magicsmoke/OCDH/README.md

View this project on [CADLAB.io](https://cadlab.io/project/25315). 

# OCDH
Open Source Diesel Heater
