magicsmoke/OCDH/ECU/pcb/ocdh_ecu.kicad_pcb

## KiCad design ECU/pcb/ocdh_ecu.kicad_pcb (2022-03-17)

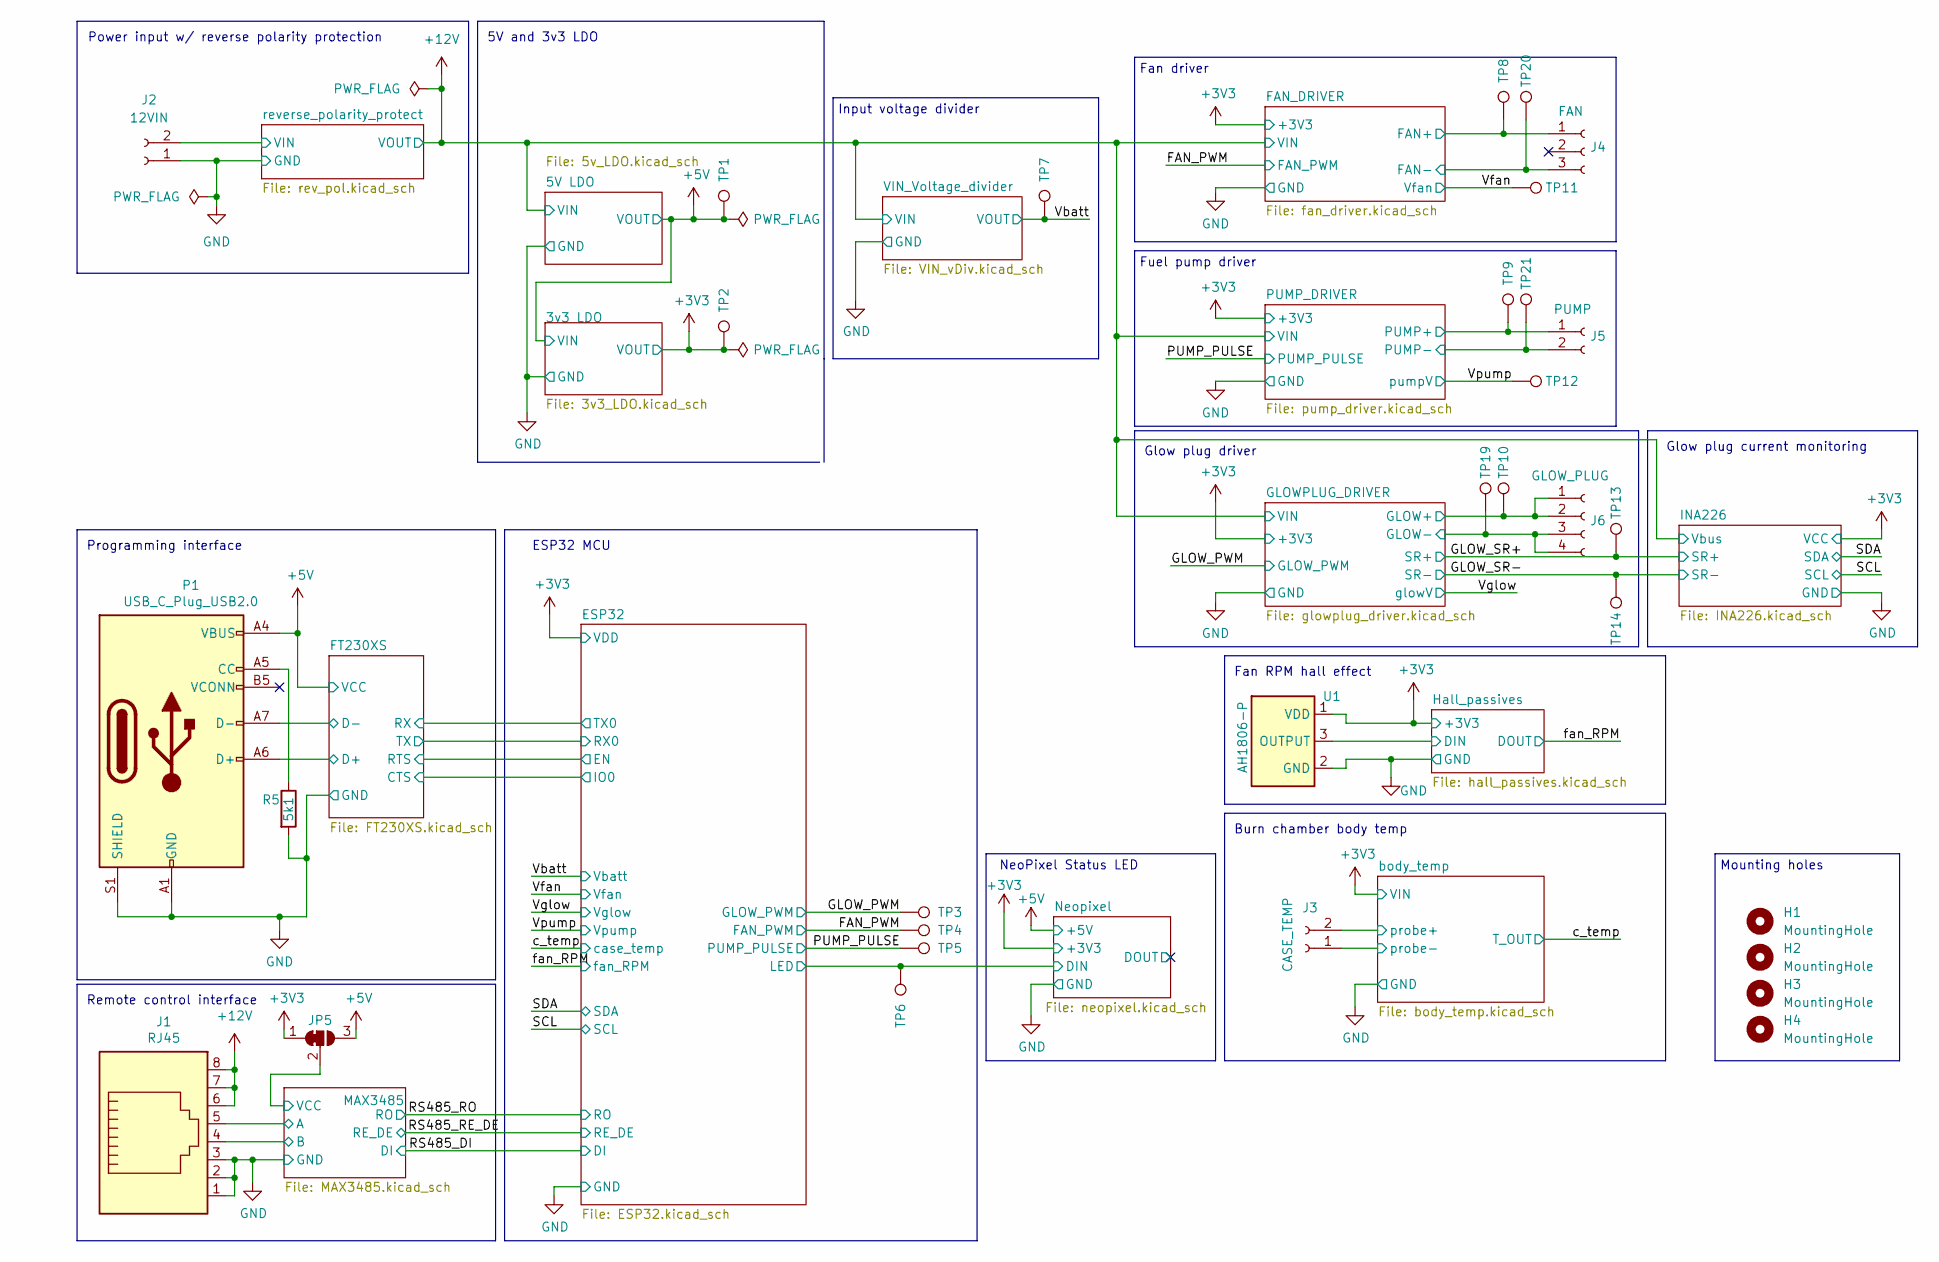
[picture p16: schematic ocdh_ecu.kicad_sch, CDH_ECU]

Parts:
H1, H2, H3, H4: MountingHole; MountingHole_3mm
J1: RJ45; RJ45_Amphenol_54602-x08_Horizontal
J2: 12VIN; SolderWire-1.5sqmm_1x02_P6mm_D1.7mm_OD3mm
J3: CASE_TEMP; SolderWire-1sqmm_1x02_P5.4mm_D1.4mm_OD2.7mm
J4: FAN; SolderWire-1sqmm_1x02_P5.4mm_D1.4mm_OD2.7mm
J5: PUMP; SolderWire-1sqmm_1x02_P5.4mm_D1.4mm_OD2.7mm
J6: GLOW_PLUG; SolderWire-1sqmm_1x02_P5.4mm_D1.4mm_OD2.7mm
JP5: RS485 PWR; SolderJumper-3_P1.3mm_Bridged12_RoundedPad1.0x1.5mm
P1: USB_C_Plug_USB2.0; GCT_USB4105-GF-A
R5: 5k1; R_0805_2012Metric
TP1, TP2, TP3, TP4, TP5, TP6, TP7, TP8, TP9, TP10, TP11, TP12, TP13, TP14, TP19, TP20, TP21: TestPoint; TestPoint_Pad_D1.5mm
U1: AH1806-P; TO265P160X410X495-3P

Connections:
+3V3: JP5.1 (A), TP2.1, U1.1 (VDD); also elsewhere on the board
+5V: JP5.3 (B), P1.A4 (VBUS), P1.A9 (VBUS), P1.B4 (VBUS), P1.B9 (VBUS), TP1.1; also elsewhere on the board
+12V: J1.6, J1.7, J1.8, J6.1, J6.2, TP10.1; also elsewhere on the board
/FAN_DRIVER/FAN+: J4.1, TP8.1; also elsewhere on the board
/FAN_DRIVER/FAN-: J4.3, TP20.1; also elsewhere on the board
/FAN_PWM: TP4.1; also elsewhere on the board
/FT230XS/D+: P1.A6 (D+), P1.B6 (D+); also elsewhere on the board
/FT230XS/D-: P1.A7 (D-), P1.B7 (D-); also elsewhere on the board
/GLOWPLUG_DRIVER/GLOW-: J6.3, J6.4, TP19.1; also elsewhere on the board
/GLOW_PWM: TP3.1; also elsewhere on the board
/GLOW_SR+: TP13.1; also elsewhere on the board
/GLOW_SR-: TP14.1; also elsewhere on the board
/Hall_passives/DIN: U1.3 (OUTPUT); also elsewhere on the board
/MAX3485/A: J1.5; also elsewhere on the board
/MAX3485/B: J1.4; also elsewhere on the board
/MAX3485/VCC: JP5.2 (C); also elsewhere on the board
/PUMP_DRIVER/PUMP+: J5.1, TP9.1; also elsewhere on the board
/PUMP_DRIVER/PUMP-: J5.2, TP21.1; also elsewhere on the board
/PUMP_PULSE: TP5.1; also elsewhere on the board
/Vbatt: TP7.1; also elsewhere on the board
/Vfan: TP11.1; also elsewhere on the board
/Vpump: TP12.1; also elsewhere on the board
/body_temp/probe+: J3.2; also elsewhere on the board
/body_temp/probe-: J3.1; also elsewhere on the board
/reverse_polarity_protect/VIN: J2.2; also elsewhere on the board
GND: J1.1, J1.2, J1.3, J2.1, P1.A1 (GND), P1.A12 (GND), P1.B1 (GND), P1.B12 (GND), P1.S1 (SHIELD), R5.2, U1.2 (GND); also elsewhere on the board
unnamed: P1.A5 (CC), R5.1

Notes on the sheet:
NeoPixel Status LED
Burn chamber body temp
ESP32 MCU
Programming interface
Fuel pump driver
5V and 3v3 LDO
Fan RPM hall effect
Glow plug current monitoring
Power input w/ reverse polarity protection
Input voltage divider
Remote control interface
Mounting holes
Glow plug driver
Fan driver

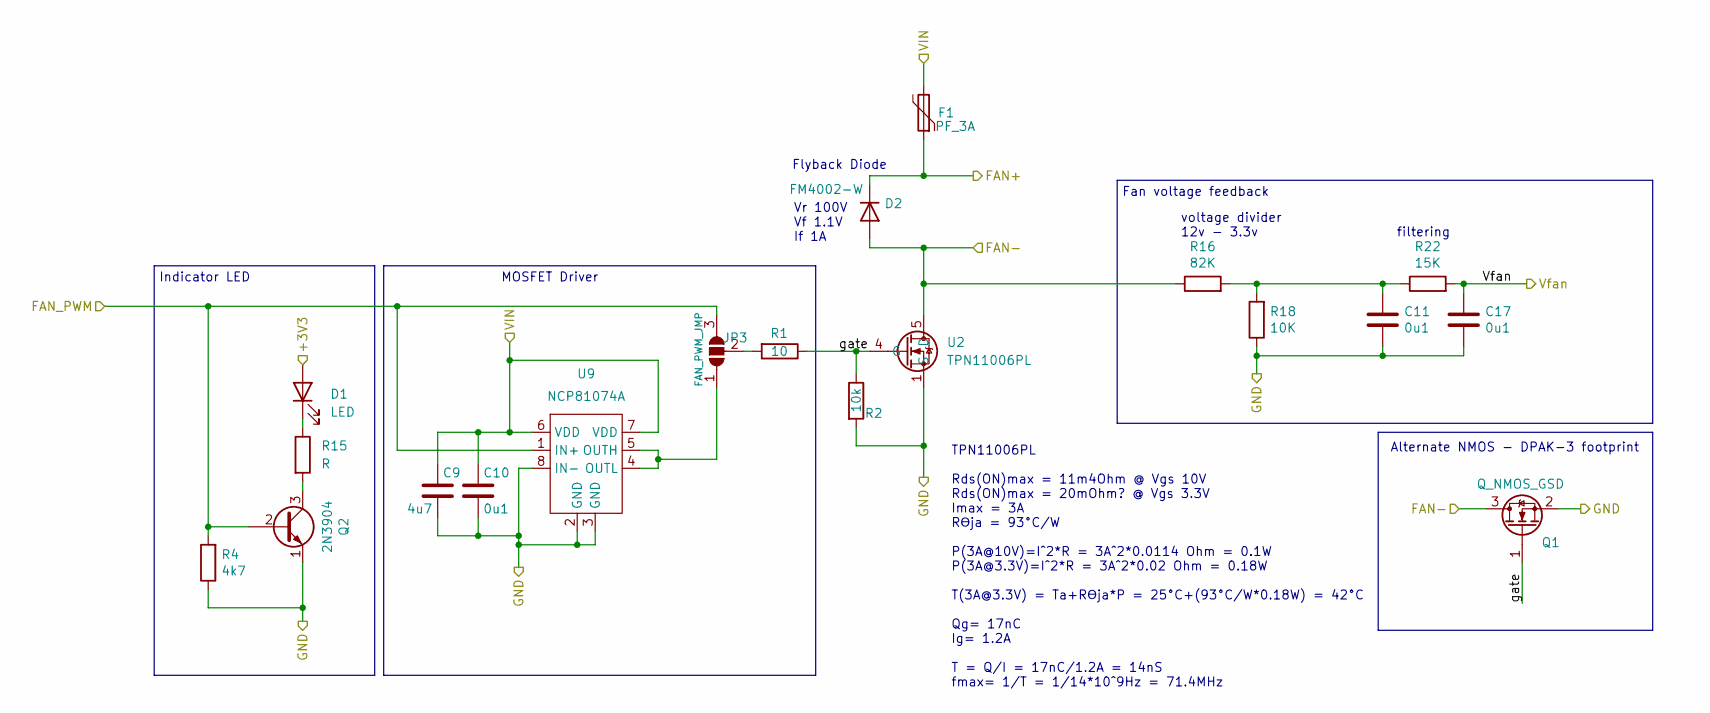
[picture p17: schematic fan_driver.kicad_sch, CDH_ECU]

Parts:
C9: 4u7; C_0805_2012Metric
C10, C11, C17: 0u1; C_0805_2012Metric
D1: LED; LEDC1608X80N
D2: FM4002-W; DIOM5025X231N
F1: PF_3A; Fuse_1812_4532Metric
JP3: FAN_PWM_JMP; SolderJumper-3_P1.3mm_Open_RoundedPad1.0x1.5mm_NumberLabels
Q1: Q_NMOS_GSD; TO-252-2
Q2: 2N3904; SOT-23
R1: 10; R_0805_2012Metric
R2: 10k; R_0805_2012Metric
R4: 4k7; R_0805_2012Metric
R15: R; R_0805_2012Metric
R16: 82K; R_0805_2012Metric
R18: 10K; R_0805_2012Metric
R22: 15K; R_0805_2012Metric
U2: TPN11006PL; VSON-8_3.3x3.3mm_P0.65mm_NexFET
U9: NCP81074A; SOIC-8_3.9x4.9mm_P1.27mm

Connections:
+3V3: D1.2 (A); also elsewhere on the board
+12V: C9.1, C10.1, F1.2, U9.6 (VDD), U9.7 (VDD); also elsewhere on the board
/FAN_DRIVER/FAN+: D2.1 (K), F1.1; also elsewhere on the board
/FAN_DRIVER/FAN-: D2.2 (A), Q1.3 (D), R16.1, U2.5 (D); also elsewhere on the board
/FAN_DRIVER/gate: Q1.1 (G), R1.1, R2.1, U2.4 (G)
/FAN_PWM: JP3.3 (B), Q2.2 (B), R4.2, U9.1 (IN+); also elsewhere on the board
/Vfan: C17.1, R22.2; also elsewhere on the board
GND: C9.2, C10.2, C11.2, C17.2, Q1.2 (S), Q2.1 (E), R2.2, R4.1, R18.1, U2.1 (S), U2.2 (S), U2.3 (S), U9.2 (GND), U9.3 (GND), U9.8 (IN-); also elsewhere on the board
unnamed: C11.1, R16.2, R18.2, R22.1
unnamed: D1.1 (K), R15.1
unnamed: JP3.1 (A), U9.4 (OUTL), U9.5 (OUTH)
unnamed: JP3.2 (C), R1.2
unnamed: Q2.3 (C), R15.2

Notes on the sheet:
filtering
TPN11006PL Rds(ON)max = 11m4Ohm @ Vgs 10V Rds(ON)max = 20mOhm? @ Vgs 3.3V Imax = 3A Rϴja = 93°C/W P(3A@10V)=I^2*R = 3A^2*0.0114 Ohm = 0.1W P(3A@3.3V)=I^2*R = 3A^2*0.02 Ohm = 0.18W T(3A@3.3V) = Ta+Rϴja*P = 25°C+(93°C/W*0.18W) = 42°C Qg= 17nC Ig= 1.2A T = Q/I = 17nC/1.2A = 14nS fmax= 1/T = 1/14*10^9H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
Indicator LED
Alternate NMOS - DPAK-3 footprint
Fan voltage feedback
Vr 100V Vf 1.1V If 1A
Flyback Diode
voltage divider 12v - 3.3v
MOSFET Driver

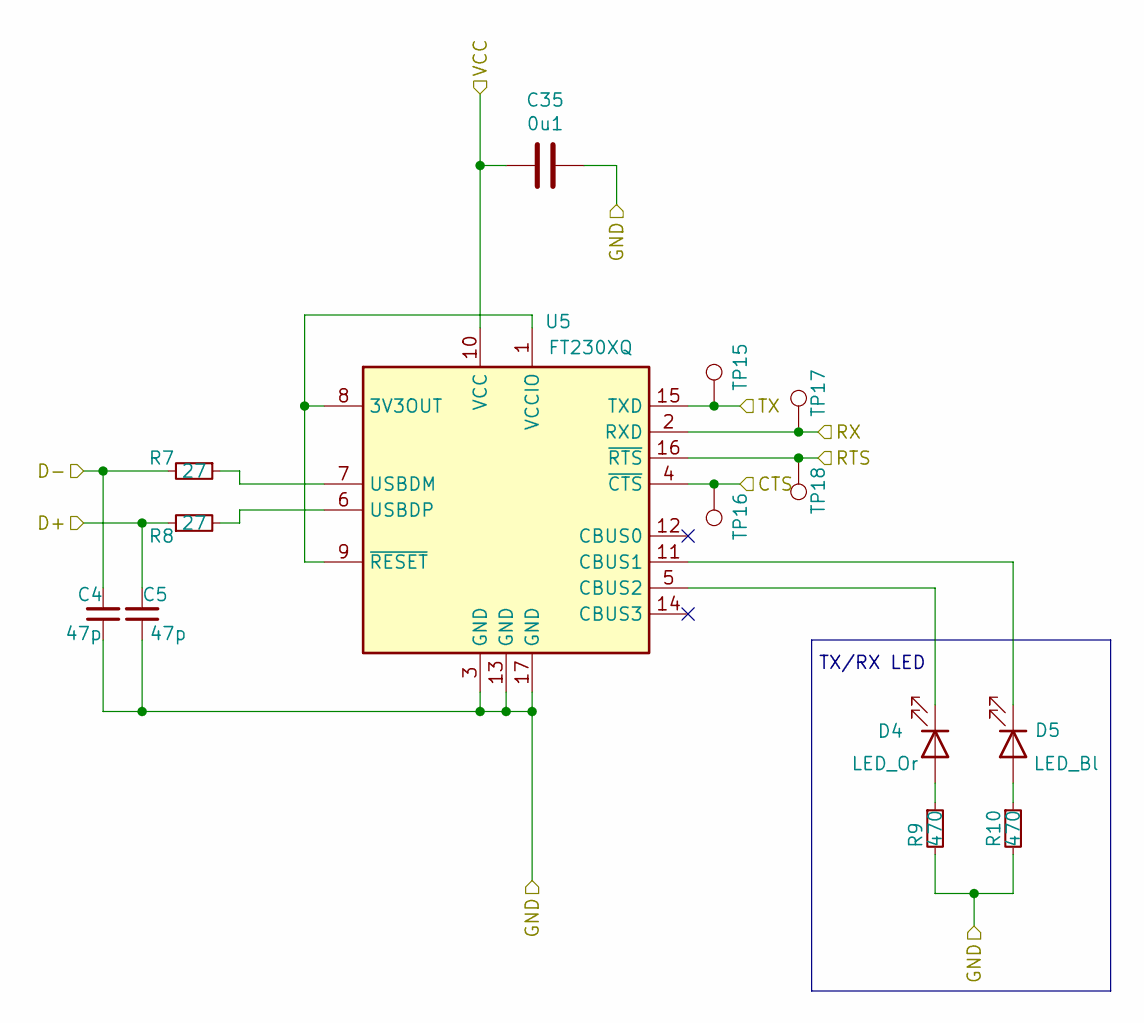
[picture p18: schematic FT230XS.kicad_sch, CDH_ECU]

Parts:
C4, C5: 47p; C_0805_2012Metric
C35: 0u1; C_0805_2012Metric
D4: LED_Or; LEDC1608X80N
D5: LED_Bl; LEDC1608X80N
R7, R8: 27; R_0805_2012Metric
R9, R10: 470; R_0805_2012Metric
TP15, TP16, TP17, TP18: TestPoint; TestPoint_Pad_D1.5mm
U5: FT230XQ; QFN-16-1EP_4x4mm_P0.65mm_EP2.1x2.1mm

Connections:
+5V: C35.2, U5.10 (VCC); also elsewhere on the board
/ESP32/EN: TP18.1, U5.16 (~RTS); also elsewhere on the board
/ESP32/IO0: TP16.1, U5.4 (~CTS); also elsewhere on the board
/ESP32/RX0: TP15.1, U5.15 (TXD); also elsewhere on the board
/ESP32/TX0: TP17.1, U5.2 (RXD); also elsewhere on the board
/FT230XS/D+: C5.2, R8.1; also elsewhere on the board
/FT230XS/D-: C4.2, R7.2; also elsewhere on the board
GND: C4.1, C5.1, C35.1, R9.2, R10.2, U5.3 (GND), U5.13 (GND), U5.17 (GND); also elsewhere on the board
unnamed: D4.1 (K), U5.5 (CBUS2)
unnamed: D4.2 (A), R9.1
unnamed: D5.1 (K), U5.11 (CBUS1)
unnamed: D5.2 (A), R10.1
unnamed: R7.1, U5.7 (USBDM)
unnamed: R8.2, U5.6 (USBDP)
unnamed: U5.1 (VCCIO), U5.8 (3V3OUT), U5.9 (~RESET)

Notes on the sheet:
TX/RX LED

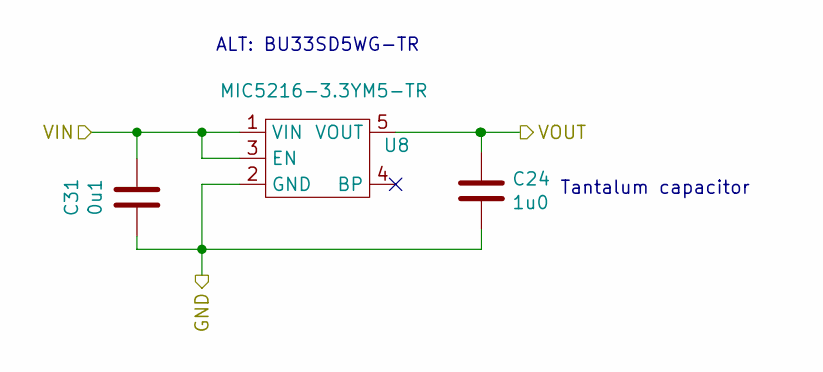
[picture p19: schematic 3v3_LDO.kicad_sch, CDH_ECU]

Parts:
C24: 1u0; C_0805_2012Metric
C31: 0u1; C_0805_2012Metric
U8: MIC5216-3.3YM5-TR; SOT-23-5

Connections:
+3V3: C24.1, U8.5 (VOUT); also elsewhere on the board
+5V: C31.1, U8.1 (VIN), U8.3 (EN); also elsewhere on the board
GND: C24.2, C31.2, U8.2 (GND); also elsewhere on the board

Notes on the sheet:
Tantalum capacitor
ALT: BU33SD5WG-TR

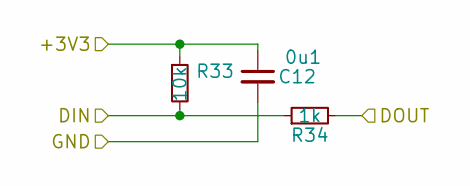
[picture p20: schematic hall_passives.kicad_sch, CDH_ECU]

Parts:
C12: 0u1; C_0805_2012Metric
R33: 10k; R_0805_2012Metric
R34: 1k; R_0805_2012Metric

Connections:
+3V3: C12.1, R33.1; also elsewhere on the board
/Hall_passives/DIN: R33.2, R34.1; also elsewhere on the board
/fan_RPM: R34.2; also elsewhere on the board
GND: C12.2; also elsewhere on the board

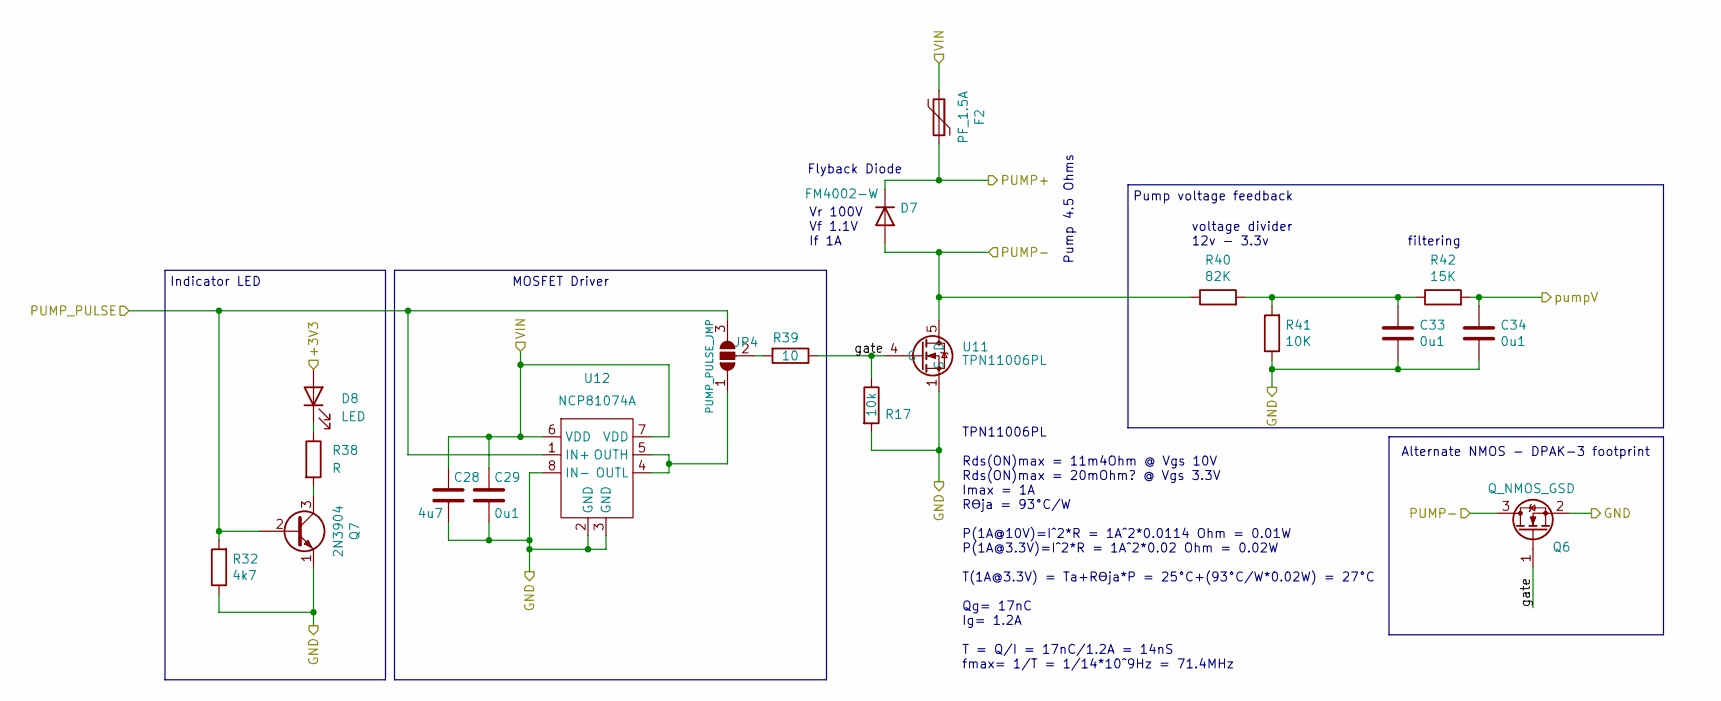
[picture p21: schematic pump_driver.kicad_sch, CDH_ECU]

Parts:
C28: 4u7; C_0805_2012Metric
C29, C33, C34: 0u1; C_0805_2012Metric
D7: FM4002-W; DIOM5025X231N
D8: LED; LEDC1608X80N
F2: PF_1.5A; FUSC5141X160N
JP4: PUMP_PULSE_JMP; SolderJumper-3_P1.3mm_Open_RoundedPad1.0x1.5mm_NumberLabels
Q6: Q_NMOS_GSD; TO-252-2
Q7: 2N3904; SOT-23
R17: 10k; R_0805_2012Metric
R32: 4k7; R_0805_2012Metric
R38: R; R_0805_2012Metric
R39: 10; R_0805_2012Metric
R40: 82K; R_0805_2012Metric
R41: 10K; R_0805_2012Metric
R42: 15K; R_0805_2012Metric
U11: TPN11006PL; VSON-8_3.3x3.3mm_P0.65mm_NexFET
U12: NCP81074A; SOIC-8_3.9x4.9mm_P1.27mm

Connections:
+3V3: D8.2 (A); also elsewhere on the board
+12V: C28.1, C29.1, F2.2, U12.6 (VDD), U12.7 (VDD); also elsewhere on the board
/PUMP_DRIVER/PUMP+: D7.1 (K), F2.1; also elsewhere on the board
/PUMP_DRIVER/PUMP-: D7.2 (A), Q6.3 (D), R40.1, U11.5 (D); also elsewhere on the board
/PUMP_DRIVER/gate: Q6.1 (G), R17.1, R39.1, U11.4 (G)
/PUMP_PULSE: JP4.3 (B), Q7.2 (B), R32.2, U12.1 (IN+); also elsewhere on the board
/Vpump: C34.1, R42.2; also elsewhere on the board
GND: C28.2, C29.2, C33.2, C34.2, Q6.2 (S), Q7.1 (E), R17.2, R32.1, R41.1, U11.1 (S), U11.2 (S), U11.3 (S), U12.2 (GND), U12.3 (GND), U12.8 (IN-); also elsewhere on the board
unnamed: C33.1, R40.2, R41.2, R42.1
unnamed: D8.1 (K), R38.1
unnamed: JP4.1 (A), U12.4 (OUTL), U12.5 (OUTH)
unnamed: JP4.2 (C), R39.2
unnamed: Q7.3 (C), R38.2

Notes on the sheet:
Flyback Diode
Vr 100V Vf 1.1V If 1A
Pump 4.5 Ohms
MOSFET Driver
filtering
voltage divider 12v - 3.3v
TPN11006PL Rds(ON)max = 11m4Ohm @ Vgs 10V Rds(ON)max = 20mOhm? @ Vgs 3.3V Imax = 1A Rϴja = 93°C/W P(1A@10V)=I^2*R = 1A^2*0.0114 Ohm = 0.01W P(1A@3.3V)=I^2*R = 1A^2*0.02 Ohm = 0.02W T(1A@3.3V) = Ta+Rϴja*P = 25°C+(93°C/W*0.02W) = 27°C Qg= 17nC Ig= 1.2A T = Q/I = 17nC/1.2A = 14nS fmax= 1/T = 1/14*10^9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
Indicator LED
Alternate NMOS - DPAK-3 footprint
Pump voltage feedback

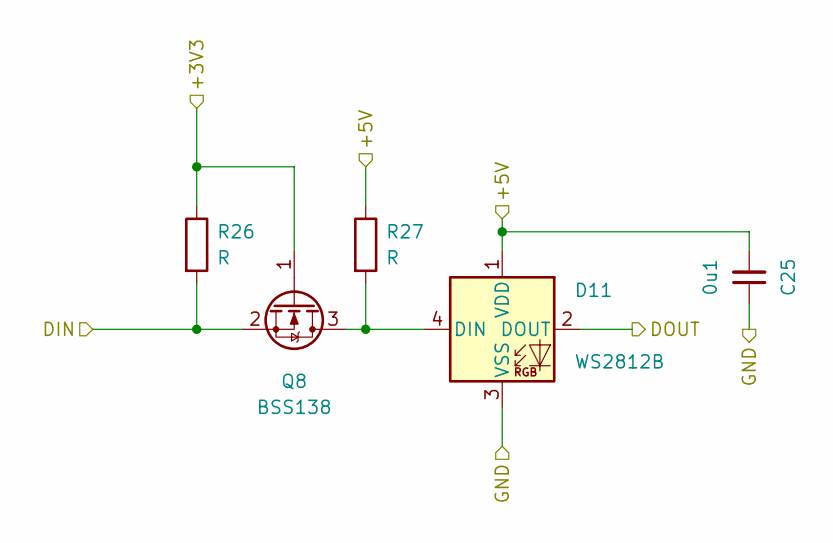
[picture p22: schematic neopixel.kicad_sch, CDH_ECU]

Parts:
C25: 0u1; C_0805_2012Metric
D11: WS2812B; LED_WS2812B_PLCC4_5.0x5.0mm_P3.2mm
Q8: BSS138; SOT-23
R26, R27: R; R_0805_2012Metric

Connections:
+3V3: Q8.1 (G), R26.1; also elsewhere on the board
+5V: C25.2, D11.1 (VDD), R27.1; also elsewhere on the board
/ESP32/LED: Q8.2 (S), R26.2; also elsewhere on the board
/Neopixel/DOUT: D11.2 (DOUT)
GND: C25.1, D11.3 (VSS); also elsewhere on the board
unnamed: D11.4 (DIN), Q8.3 (D), R27.2

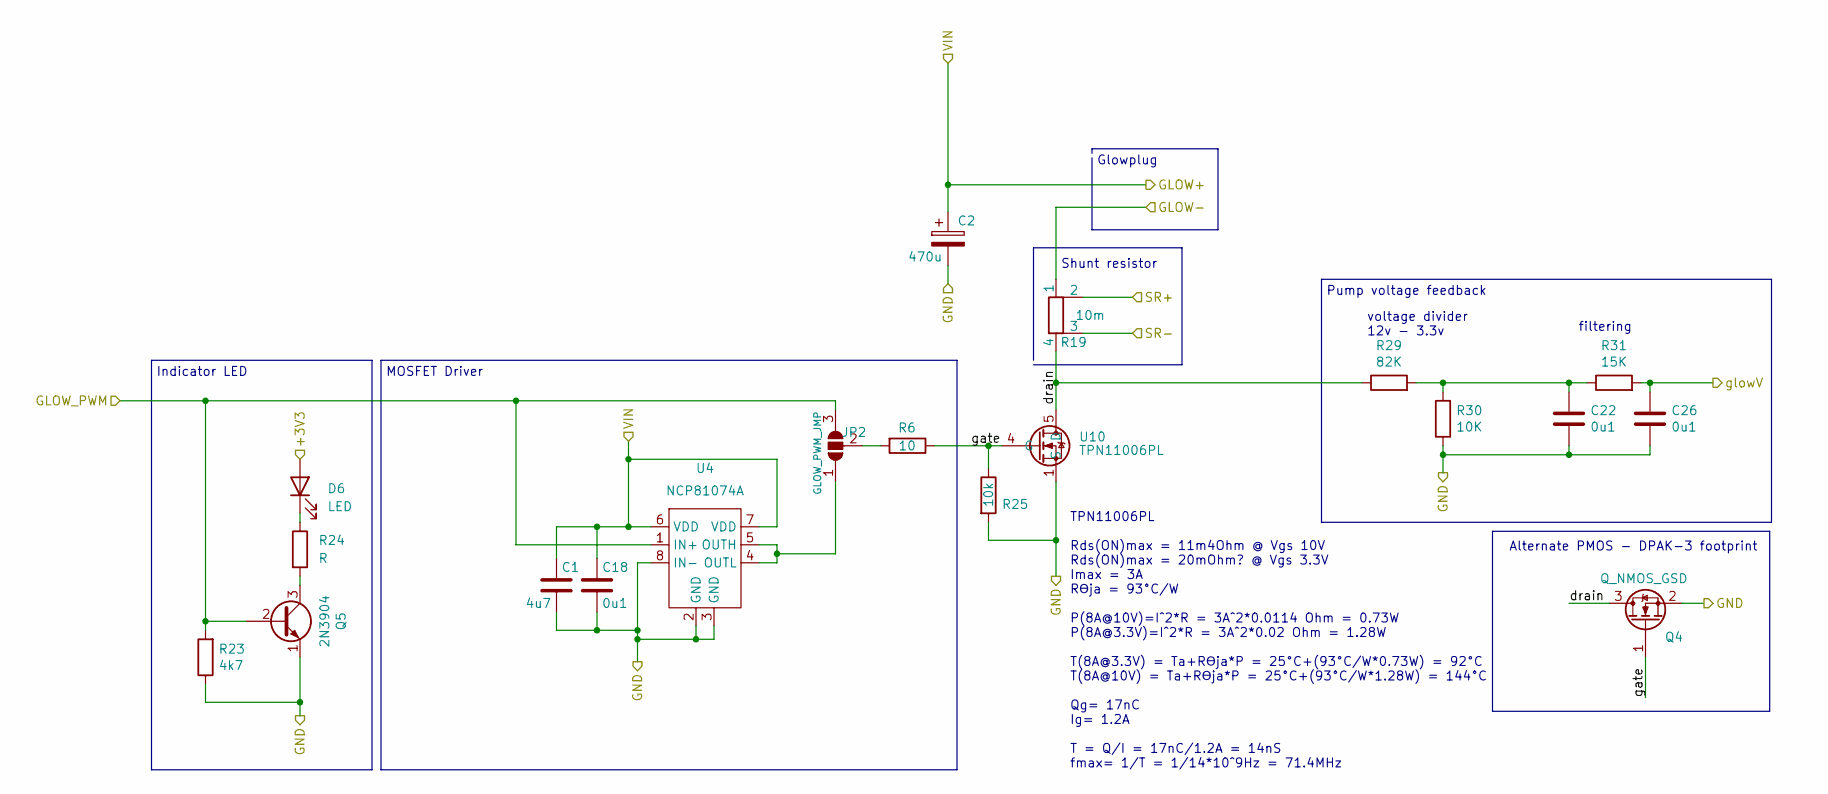
[picture p23: schematic glowplug_driver.kicad_sch, CDH_ECU]

Parts:
C1: 4u7; C_0805_2012Metric
C2: 470u; CP_Radial_D10.0mm_P5.00mm
C18, C22, C26: 0u1; C_0805_2012Metric
D6: LED; LEDC1608X80N
JP2: GLOW_PWM_JMP; SolderJumper-3_P1.3mm_Open_RoundedPad1.0x1.5mm_NumberLabels
Q4: Q_NMOS_GSD; TO-252-2
Q5: 2N3904; SOT-23
R6: 10; R_0805_2012Metric
R19: 10m; R_Shunt_Vishay_WSK2512_6332Metric_T1.19mm
R23: 4k7; R_0805_2012Metric
R24: R; R_0805_2012Metric
R25: 10k; R_0805_2012Metric
R29: 82K; R_0805_2012Metric
R30: 10K; R_0805_2012Metric
R31: 15K; R_0805_2012Metric
U4: NCP81074A; SOIC-8_3.9x4.9mm_P1.27mm
U10: TPN11006PL; VSON-8_3.3x3.3mm_P0.65mm_NexFET

Connections:
+3V3: D6.2 (A); also elsewhere on the board
+12V: C1.1, C2.1, C18.1, U4.6 (VDD), U4.7 (VDD); also elsewhere on the board
/GLOWPLUG_DRIVER/GLOW-: R19.1; also elsewhere on the board
/GLOWPLUG_DRIVER/drain: Q4.3 (D), R19.4, R29.1, U10.5 (D)
/GLOWPLUG_DRIVER/gate: Q4.1 (G), R6.1, R25.1, U10.4 (G)
/GLOW_PWM: JP2.3 (B), Q5.2 (B), R23.2, U4.1 (IN+); also elsewhere on the board
/GLOW_SR+: R19.2; also elsewhere on the board
/GLOW_SR-: R19.3; also elsewhere on the board
/Vglow: C26.1, R31.2; also elsewhere on the board
GND: C1.2, C2.2, C18.2, C22.2, C26.2, Q4.2 (S), Q5.1 (E), R23.1, R25.2, R30.1, U4.2 (GND), U4.3 (GND), U4.8 (IN-), U10.1 (S), U10.2 (S), U10.3 (S); also elsewhere on the board
unnamed: C22.1, R29.2, R30.2, R31.1
unnamed: D6.1 (K), R24.1
unnamed: JP2.1 (A), U4.4 (OUTL), U4.5 (OUTH)
unnamed: JP2.2 (C), R6.2
unnamed: Q5.3 (C), R24.2

Notes on the sheet:
Alternate PMOS - DPAK-3 footprint
Shunt resistor
Pump voltage feedback
voltage divider 12v - 3.3v
MOSFET Driver
Glowplug
TPN11006PL Rds(ON)max = 11m4Ohm @ Vgs 10V Rds(ON)max = 20mOhm? @ Vgs 3.3V Imax = 3A Rϴja = 93°C/W P(8A@10V)=I^2*R = 3A^2*0.0114 Ohm = 0.73W P(8A@3.3V)=I^2*R = 3A^2*0.02 Ohm = 1.28W T(8A@3.3V) = Ta+Rϴja*P = 25°C+(93°C/W*0.73W) = 92°C T(8A@10V) = Ta+Rϴja*P = 25°C+(93°C/W*1.28W) = 144°C Qg= 17nC Ig= 1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
Indicator LED
filtering

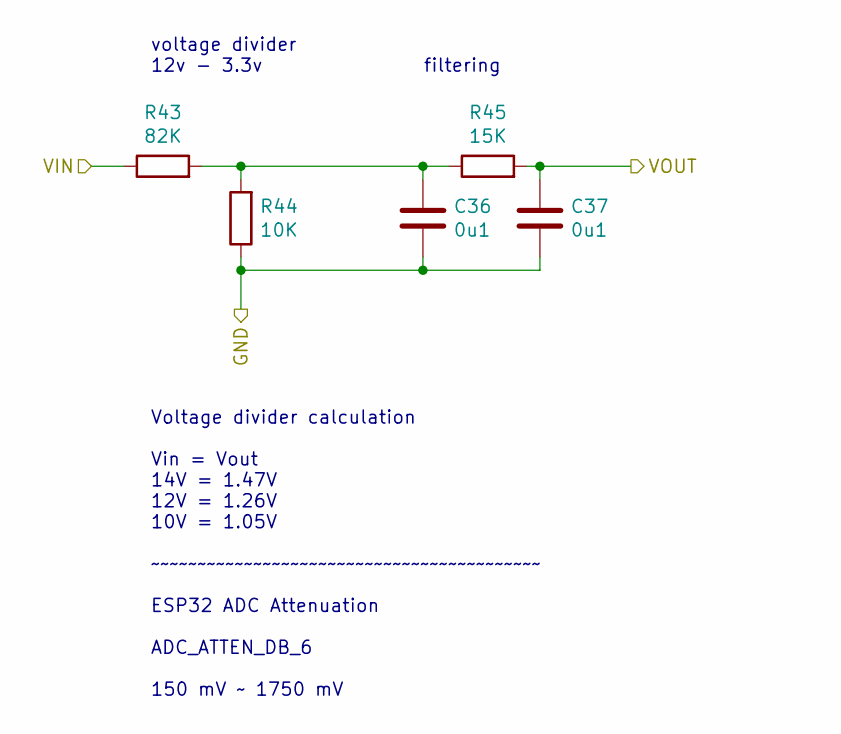
[picture p24: schematic VIN_vDiv.kicad_sch, CDH_ECU]

Parts:
C36, C37: 0u1; C_0805_2012Metric
R43: 82K; R_0805_2012Metric
R44: 10K; R_0805_2012Metric
R45: 15K; R_0805_2012Metric

Connections:
+12V: R43.1; also elsewhere on the board
/Vbatt: C37.1, R45.2; also elsewhere on the board
GND: C36.2, C37.2, R44.1; also elsewhere on the board
unnamed: C36.1, R43.2, R44.2, R45.1

Notes on the sheet:
filtering
Voltage divider calculation Vin = Vout 14V = 1.47V 12V = 1.26V 10V = 1.05V ~~~~~~~~~~~~~~~~~~~~~~~~~~~~~~~~~~~~~~~~~~ ESP32 ADC Attenuation ADC_ATTEN_DB_6 150 mV ~ 1750 mV
voltage divider 12v - 3.3v

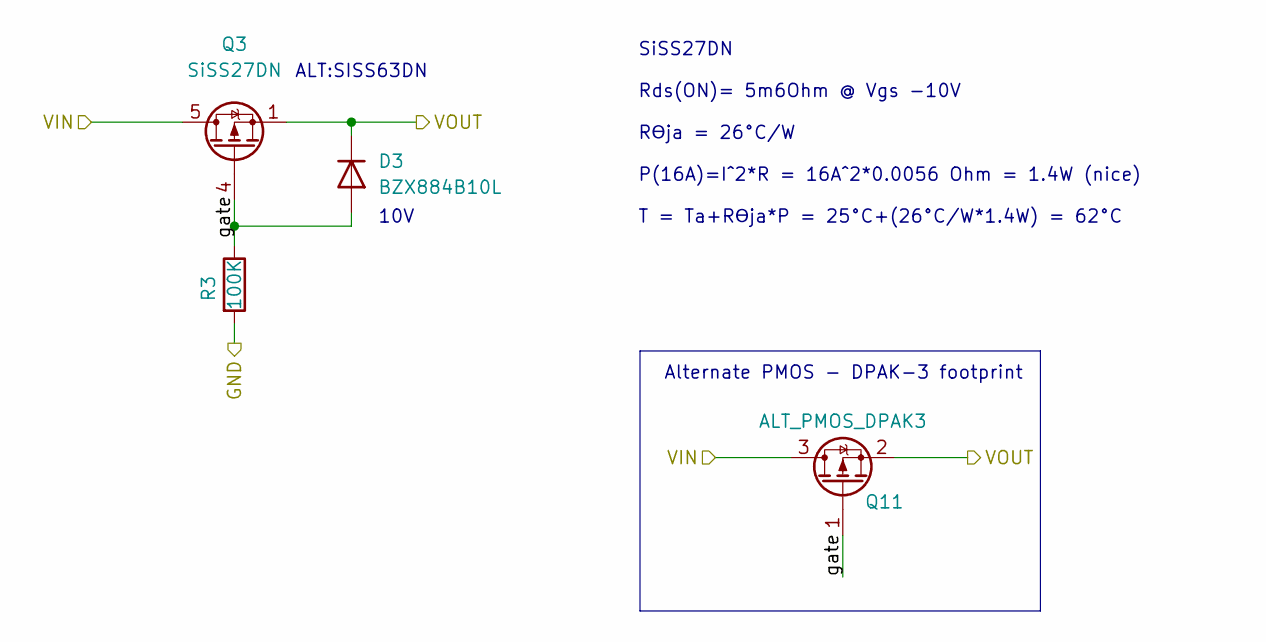
[picture p25: schematic rev_pol.kicad_sch, CDH_ECU]

Parts:
D3: BZX884B10L; D_0402_1005Metric
Q3: SiSS27DN; Vishay_PowerPAK_1212-8_Single
Q11: ALT_PMOS_DPAK3; TO-252-2
R3: 100K; R_0805_2012Metric

Connections:
+12V: D3.1 (K), Q3.1 (S), Q3.2 (S), Q3.3 (S), Q11.2 (S); also elsewhere on the board
/reverse_polarity_protect/VIN: Q3.5 (D), Q11.3 (D); also elsewhere on the board
/reverse_polarity_protect/gate: D3.2 (A), Q3.4 (G), Q11.1 (G), R3.1
GND: R3.2; also elsewhere on the board

Notes on the sheet:
SiSS27DN Rds(ON)= 5m6Ohm @ Vgs -10V Rϴja = 26°C/W P(16A)=I^2*R = 16A^2*0.0056 Ohm = 1.4W (nice) T = Ta+Rϴja*P = 25°C+(26°C/W*1.4W) = 62°C
ALT:SISS63DN
10V
Alternate PMOS - DPAK-3 footprint

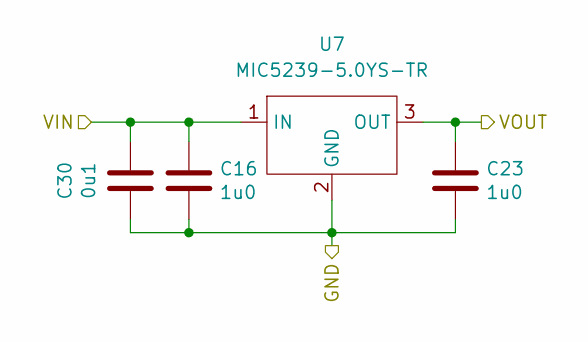
[picture p26: schematic 5v_LDO.kicad_sch, CDH_ECU]

Parts:
C16, C23: 1u0; C_0805_2012Metric
C30: 0u1; C_0805_2012Metric
U7: MIC5239-5.0YS-TR; SOT-223

Connections:
+5V: C23.1, U7.3 (OUT); also elsewhere on the board
+12V: C16.1, C30.1, U7.1 (IN); also elsewhere on the board
GND: C16.2, C23.2, C30.2, U7.2 (GND), U7.4 (GND); also elsewhere on the board

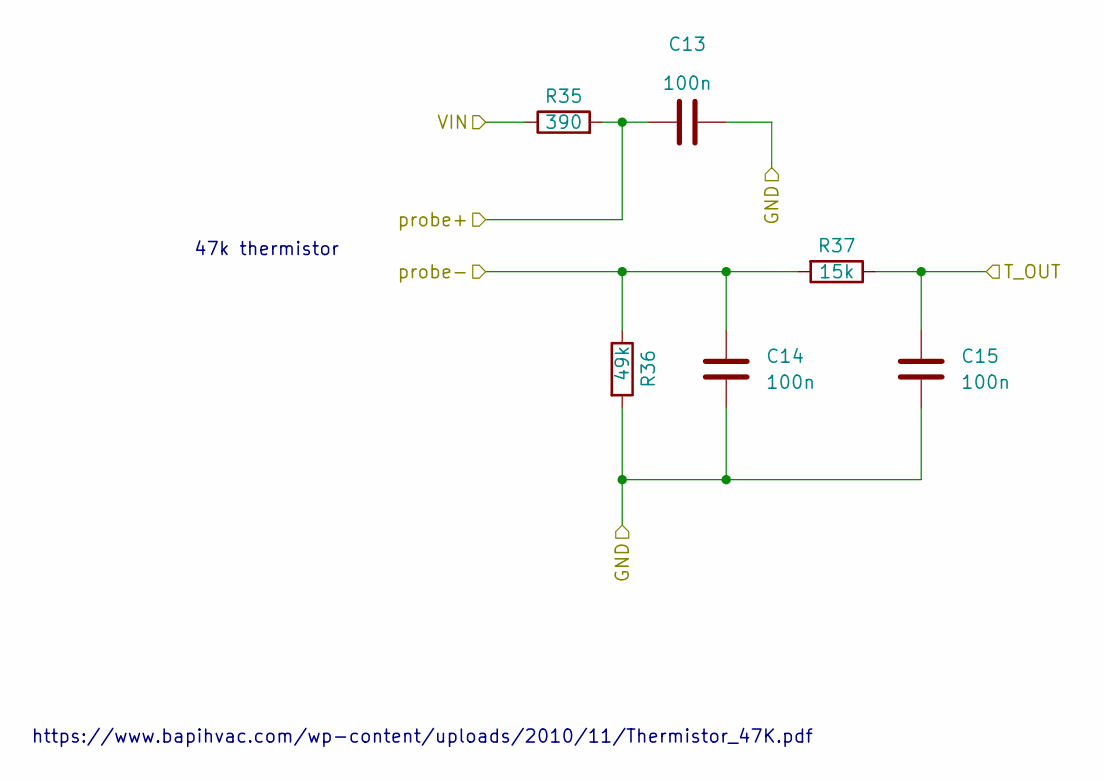
[picture p27: schematic body_temp.kicad_sch, CDH_ECU]

Parts:
C13, C14, C15: 100n; C_0805_2012Metric
R35: 390; R_0805_2012Metric
R36: 49k; R_0805_2012Metric
R37: 15k; R_0805_2012Metric

Connections:
+3V3: R35.1; also elsewhere on the board
/body_temp/probe+: C13.1, R35.2; also elsewhere on the board
/body_temp/probe-: C14.1, R36.1, R37.2; also elsewhere on the board
/c_temp: C15.1, R37.1; also elsewhere on the board
GND: C13.2, C14.2, C15.2, R36.2; also elsewhere on the board

Notes on the sheet:
https://www.bapihvac.com/wp-content/uploads/2010/11/Thermistor_47K.pdf
47k thermistor

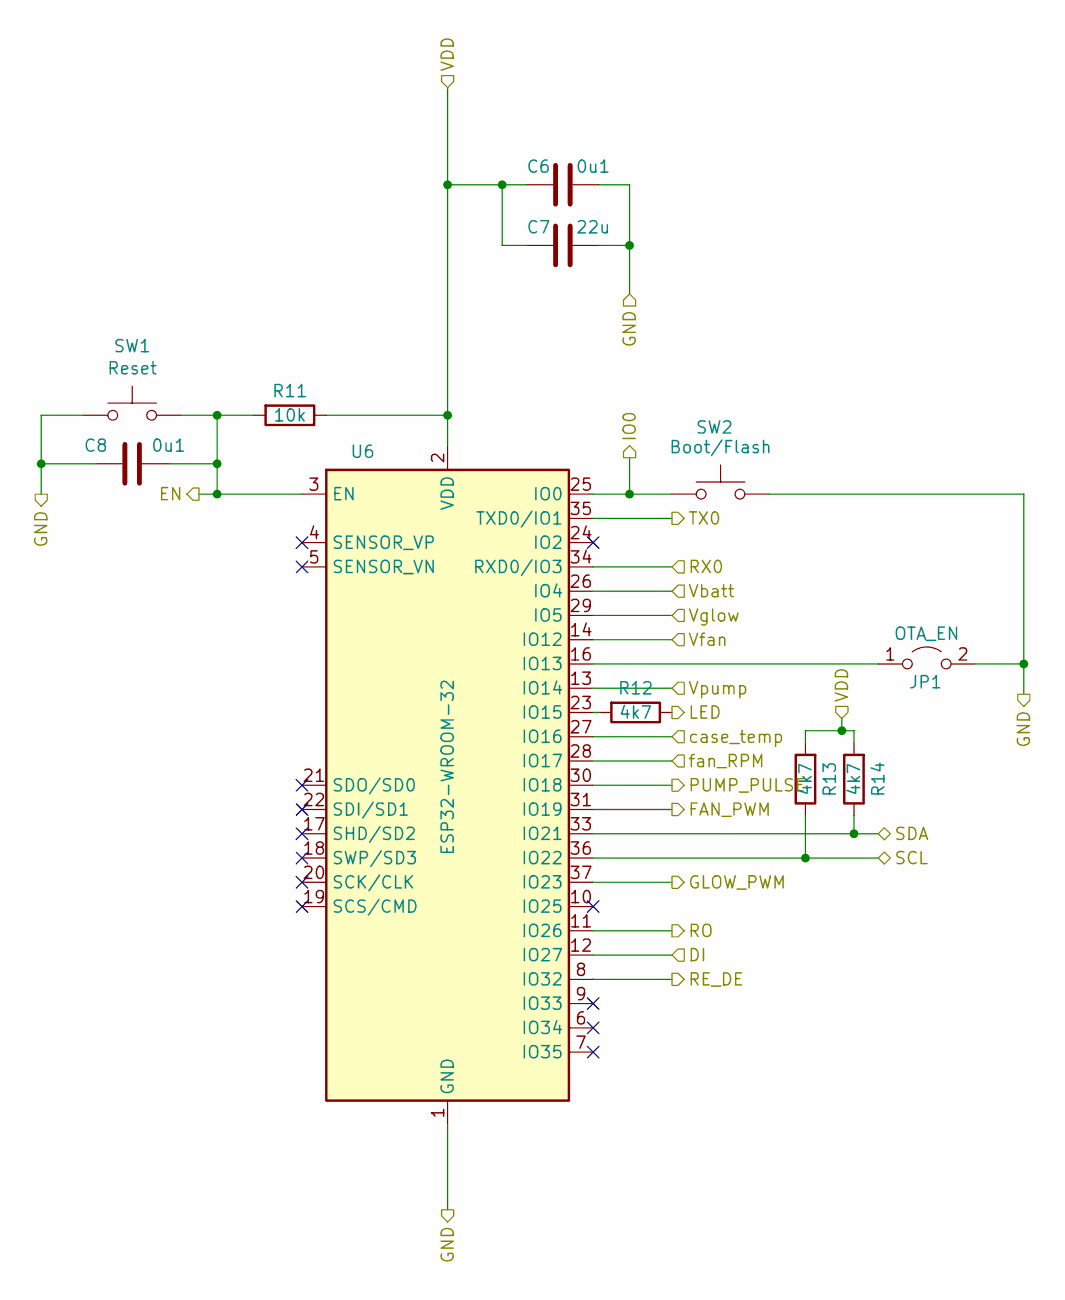
[picture p28: schematic ESP32.kicad_sch, CDH_ECU]

Parts:
C6, C8: 0u1; C_0805_2012Metric
C7: 22u; C_0805_2012Metric
JP1: OTA_EN; PinSocket_1x02_P2.54mm_Vertical
R11: 10k; R_0805_2012Metric
R12, R13, R14: 4k7; R_0805_2012Metric
SW1: Reset; SW_SPST_PTS645
SW2: Boot/Flash; PinHeader_1x02_P1.27mm_Vertical
U6: ESP32-WROOM-32

Connections:
+3V3: C6.2, C7.2, R11.1, R13.2, R14.2, U6.2 (VDD); also elsewhere on the board
/ESP32/EN: C8.1, R11.2, SW1.2, U6.3 (EN); also elsewhere on the board
/ESP32/IO0: SW2.1, U6.25 (IO0); also elsewhere on the board
/ESP32/LED: R12.1; also elsewhere on the board
/ESP32/RX0: U6.34 (RXD0/IO3); also elsewhere on the board
/ESP32/TX0: U6.35 (TXD0/IO1); also elsewhere on the board
/FAN_PWM: U6.31 (IO19); also elsewhere on the board
/GLOW_PWM: U6.37 (IO23); also elsewhere on the board
/PUMP_PULSE: U6.30 (IO18); also elsewhere on the board
/RS485_DI: U6.12 (IO27); also elsewhere on the board
/RS485_RE_DE: U6.8 (IO32); also elsewhere on the board
/RS485_RO: U6.11 (IO26); also elsewhere on the board
/SCL: R13.1, U6.36 (IO22); also elsewhere on the board
/SDA: R14.1, U6.33 (IO21); also elsewhere on the board
/Vbatt: U6.26 (IO4); also elsewhere on the board
/Vfan: U6.14 (IO12); also elsewhere on the board
/Vglow: U6.29 (IO5); also elsewhere on the board
/Vpump: U6.13 (IO14); also elsewhere on the board
/c_temp: U6.27 (IO16); also elsewhere on the board
/fan_RPM: U6.28 (IO17); also elsewhere on the board
GND: C6.1, C7.1, C8.2, JP1.2 (B), SW1.1, SW2.2, U6.1 (GND), U6.15 (GND), U6.38 (GND), U6.39 (GND); also elsewhere on the board
unnamed: JP1.1 (A), U6.16 (IO13)
unnamed: R12.2, U6.23 (IO15)

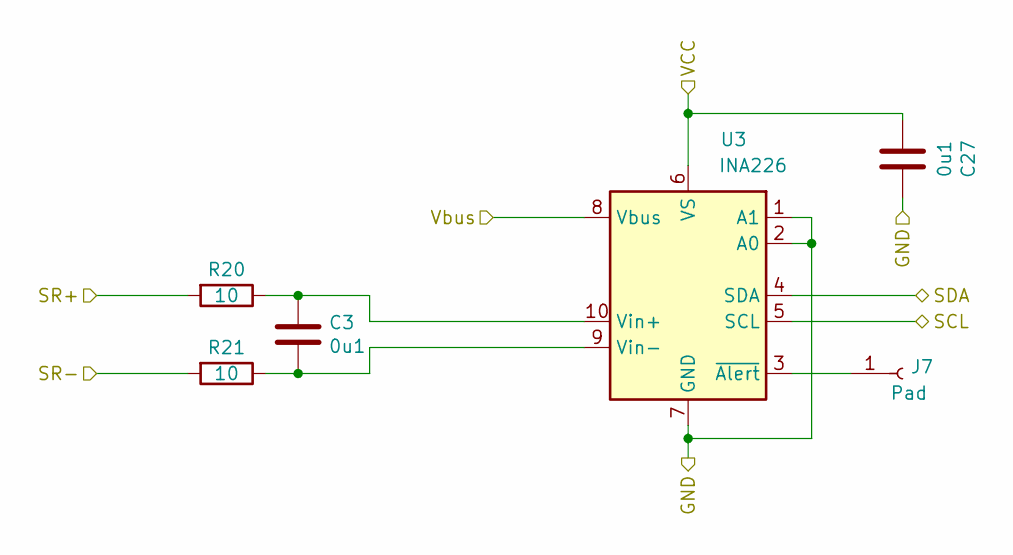
[picture p29: schematic INA226.kicad_sch, CDH_ECU]

Parts:
C3, C27: 0u1; C_0805_2012Metric
J7: Pad; TestPoint_Pad_D1.5mm
R20, R21: 10; R_0805_2012Metric
U3: INA226; VSSOP-10_3x3mm_P0.5mm

Connections:
+3V3: C27.2, U3.6 (VS); also elsewhere on the board
+12V: U3.8 (Vbus); also elsewhere on the board
/GLOW_SR+: R20.2; also elsewhere on the board
/GLOW_SR-: R21.2; also elsewhere on the board
/SCL: U3.5 (SCL); also elsewhere on the board
/SDA: U3.4 (SDA); also elsewhere on the board
GND: C27.1, U3.1 (A1), U3.2 (A0), U3.7 (GND); also elsewhere on the board
unnamed: C3.1, R21.1, U3.9 (Vin-)
unnamed: C3.2, R20.1, U3.10 (Vin+)
unnamed: J7.1, U3.3 (~Alert)

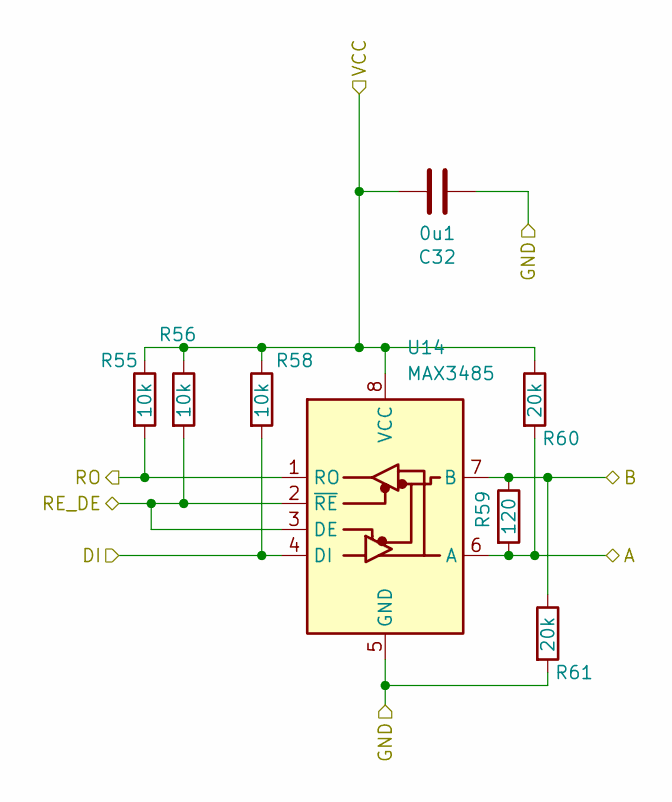
[picture p30: schematic MAX3485.kicad_sch, CDH_ECU]

Parts:
C32: 0u1; C_0805_2012Metric
R55, R56, R58: 10k; R_0805_2012Metric
R59: 120; R_0805_2012Metric
R60, R61: 20k; R_0805_2012Metric
U14: MAX3485; SOIC-8_3.9x4.9mm_P1.27mm

Connections:
/MAX3485/A: R59.2, R60.2, U14.6 (A); also elsewhere on the board
/MAX3485/B: R59.1, R61.1, U14.7 (B); also elsewhere on the board
/MAX3485/VCC: C32.1, R55.1, R56.1, R58.1, R60.1, U14.8 (VCC); also elsewhere on the board
/RS485_DI: R58.2, U14.4 (DI); also elsewhere on the board
/RS485_RE_DE: R56.2, U14.2 (~RE), U14.3 (DE); also elsewhere on the board
/RS485_RO: R55.2, U14.1 (RO); also elsewhere on the board
GND: C32.2, R61.2, U14.5 (GND); also elsewhere on the board
