magicsmoke/OCDH/ECU/pcb/ocdh_ecu.kicad_pcb

## KiCad design ECU/pcb/ocdh_ecu.kicad_pcb (continued)

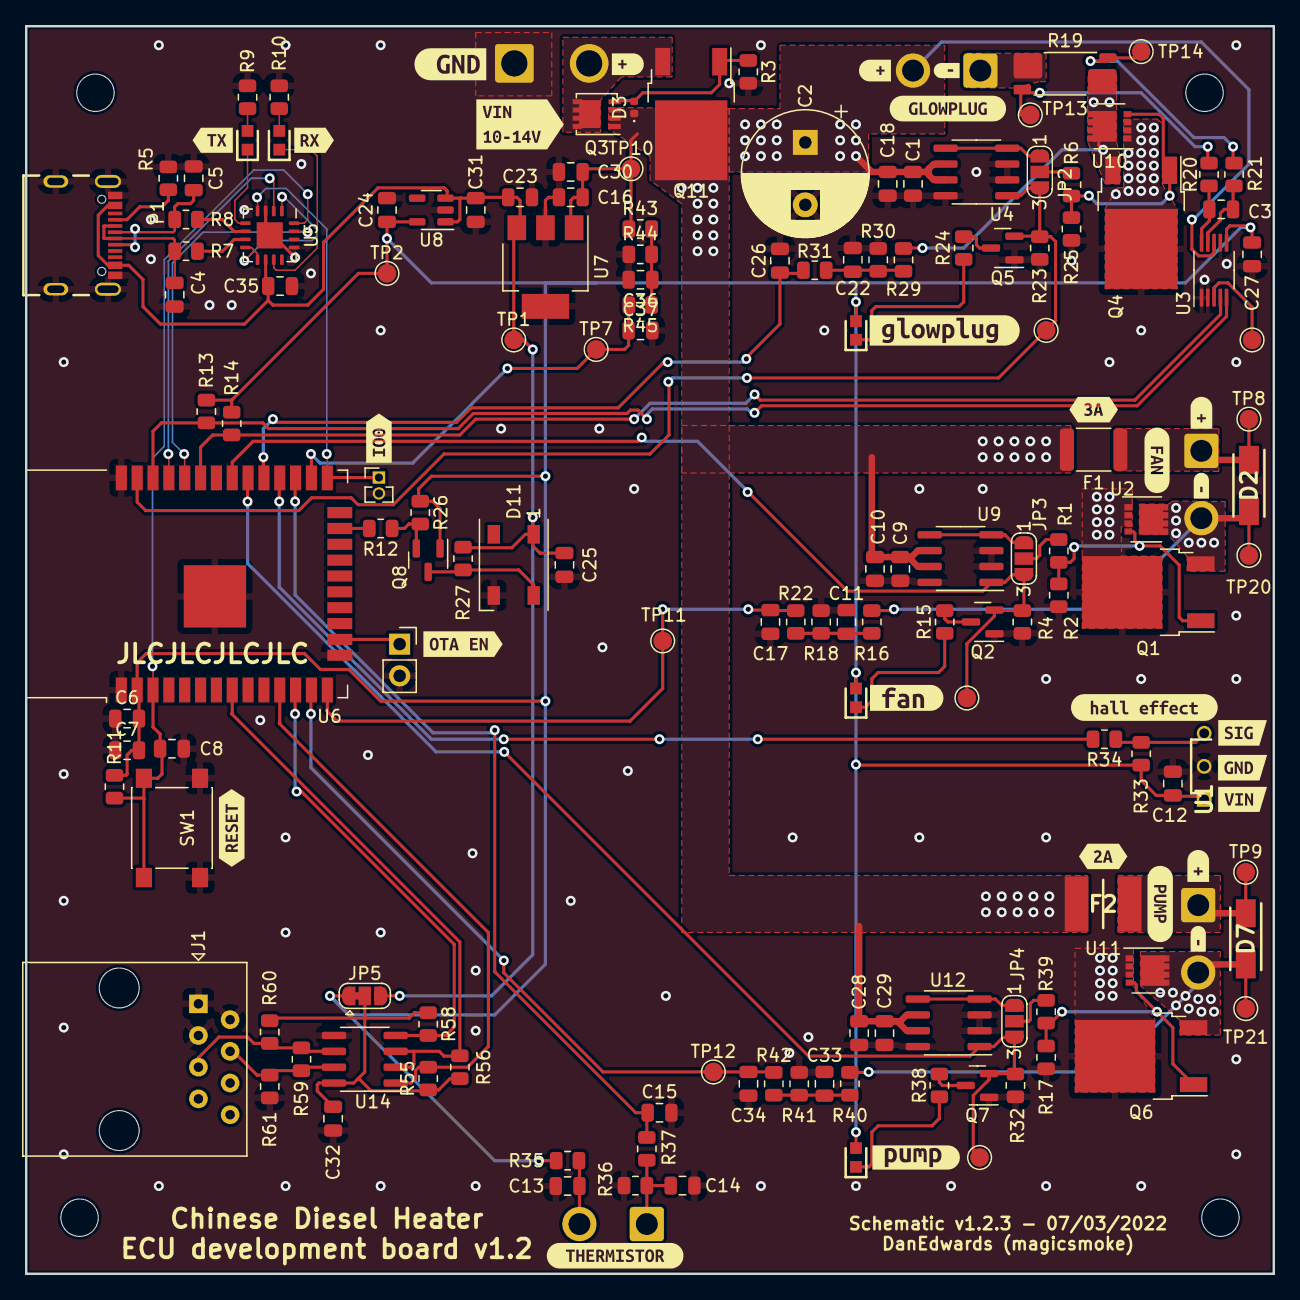
[picture p31: board ocdh_ecu.kicad_pcb from above]

Board: 4 copper layers, 100.0 x 100.0 mm, 178 parts (0 on the bottom side), 74 nets.

Other parts of the board:
kibuzzard-6225E5A1: G***; kibuzzard-6225E5A1
kibuzzard-6225F900: G***; kibuzzard-6225F900
kibuzzard-62261A13: G***; kibuzzard-62261A13
kibuzzard-62261A48, kibuzzard-62261A48#2, kibuzzard-62261A48#3: G***; kibuzzard-62261A48
kibuzzard-62261B26: G***; kibuzzard-62261B26
kibuzzard-62261B32: G***; kibuzzard-62261B32
kibuzzard-62261E42: G***; kibuzzard-62261E42
kibuzzard-62261EA9: G***; kibuzzard-62261EA9
kibuzzard-62261EF2: G***; kibuzzard-62261EF2
kibuzzard-62261EFE: G***; kibuzzard-62261EFE
kibuzzard-62261F25: G***; kibuzzard-62261F25
kibuzzard-62261FB6: G***; kibuzzard-62261FB6
kibuzzard-622601F8: G***; kibuzzard-622601F8
kibuzzard-622618BB: G***; kibuzzard-622618BB
kibuzzard-622618D3: G***; kibuzzard-622618D3
kibuzzard-622619A2: G***; kibuzzard-622619A2
kibuzzard-622619E2: G***; kibuzzard-622619E2
kibuzzard-6226198A: G***; kibuzzard-6226198A
kibuzzard-62261823: G***; kibuzzard-62261823
kibuzzard-62261844, kibuzzard-62261844#2, kibuzzard-62261844#3, kibuzzard-62261844#4: G***; kibuzzard-62261844
kibuzzard-62261864: G***; kibuzzard-62261864
kibuzzard-62262057: G***; kibuzzard-62262057
